JavierIOM/OscarGPS/(commit log)

2026-10-22 OscarGPS 1.0.0: PA1010D GPS to Bluetooth SPP NMEA for OscarWatch
    FireBeetle ESP32 reads NMEA from the Adafruit Mini GPS PA1010D over I2C,
    checks each sentence's checksum, and relays it over Bluetooth Classic SPP
    (OscarGPS) and USB serial so OscarWatch can use it as a serial NMEA GPS.
2026-10-22 OscarGPS 1.0.1: MIT licence, README for public use, I2C pin defines
    README rewritten for anyone building one (other ESP32 boards, Linux
    pairing, NMEA timing limits, troubleshooting). I2C pins are now defines,
    and platformio.ini no longer pins a COM port.
    [main.cpp]
2026-10-22 1.1.0: optional I2C OLED showing UTC, grid, satellites and BT link
    SSD1306 or SH1106 detected at boot from the status byte, at 0x3C or 0x3D,
    sharing the GPS bus. Redraws run after each RMC so they never delay a
    sentence; contrast is lowered and the layout drifts against burn-in.
    [main.cpp]
2026-10-22 80 MHz CPU and LED off with a screen fitted, for battery life
    Screen support confirmed on a 1.3" SH1106 at 0x3C (status 0x28).
2026-10-31 1.2.0: ID-52 style sky plot and signal pages, battery gauge
    Screen cycles main / sky plot / signal bars while satellites are in view.
    Optional 100k/100k divider from VCC to A0 gives a battery percentage, or
    "USB" on USB power. GSV now every second for live satellite pages.
    Not yet flashed: the board is on battery.
2026-10-31 1.3.0: retro BIOS boot screen with real peripheral checks
    Ported from the RAPT/weather displays' POST, cut down to 128x64 mono with
    a 4x6 font and a scrolling region under a fixed title bar. GPS, display,
    battery sense, Bluetooth and the first NMEA sentence are actually checked.
    [main.cpp]
2026-11-01 1.4.0: the board dials the PC's Incoming port and redials by itself
    Once paired, the board connects to the PC (found in its own bond list)
    instead of waiting for the PC, so a restart or dropout recovers with no
    action on the PC: tested at 10 s under an open COM11. The screen names the
    Incoming port to use, taken from the PC's SDP service name and kept in NVS.
2026-11-01 1.4.0 release: README flash example
    Confirmed in use: OscarWatch on the Incoming port (COM11), live fix,
    no connect failures since the switch.
2026-11-01 Add a laser-cut acrylic lid with glue-on supports and a glue jig
    enclosure/make_lid.py writes the lid and 12 support clips (3 mm acrylic)
    and a placement jig (card/MDF), with every position copied from the
    printed lid that fitted. Self-checks the jig offsets and clip clearances.
2026-11-01 Add a layered plywood box: 8 layers of 3.6 mm ply under the acrylic lid
    box.scad holds the layers (battery bay, FireBeetle corner pads, USB
    opening, corner blocks with trapped M3 nuts) copied from the printed
    base, plus an assembly preview. make_box.py exports a clean SVG for
    LightBurn. Collision check of ply vs dummy parts and lid clips: empty.
    [box.scad]
2026-11-03 1.4.1: screen rotated 180 degrees for the enclosure
    OLED_ROTATION (U8G2_R2) so the display reads the right way up in the
    box; U8G2_R0 restores the old orientation.
2026-11-04 Enclosure: USB opening 3 mm over, no USB gap in L2, no L6 slot
    From a test fit of the cut box.
    [box.scad]
2026-11-04 1.5.0: the link label says why it isn't linked, and needs a fix to say linked
    "COM11 closed" when the PC answers but nothing has its Incoming port
    open, "PC not found" when it doesn't answer, told apart by timing the
    SDP lookup (147 ms and 1109 ms present, 5140 ms absent in testing).
    "awaiting sats" when linked without a fix. Label changes go to the
    USB log.
    [main.cpp]
2026-11-04 1.6.0 (on test): Wi-Fi status page on USB power
    The board runs its own WPA2 network, OscarGPS, while on USB power, with
    a live page at 192.168.4.1: sky plot, signal bars, satellite table,
    position, altitude, speed, 10-character grid, DOPs, link, battery and
    memory. The password is generated per board on first boot and kept in
    NVS. Tested: AP visible from the PC, JSON valid over the USB api
    command, page rendered at 390 px in both themes, Bluetooth link held
    through 60 s with Wi-Fi up and no new NMEA checksum failures.
    [main.cpp]
2026-11-04 1.6.0 release: Wi-Fi status page on USB power
